X1nDon9/Rocket-onboard-computer-automatic-parachute-deployment-and-recovery-system/README.md

# Rocket-onboard-computer-automatic-parachute-deployment-and-recovery-system
来自哈尔滨工业大学的学生团队,设计结构并研发了火箭机载控制系统,完成了非常简单的功能,这是我们两周时间验证力学结构设计和嵌入式开发的重要探索
