X1nDon9/Rocket-onboard-computer-automatic-parachute-deployment-and-recovery-system/Satellite/satelite说明.md

这是一个基于stm32f103c8t6的小卫星,结构简单
主要的功能外设硬件有BMP280气压计,IMU9250,LORA_433MHz(ATK285-1)
还有一个简单的小MG90S舵机作为卫星弹簧开伞的限位模块
