X1nDon9/Rocket-onboard-computer-automatic-parachute-deployment-and-recovery-system/Rocket main/code/火箭机载电脑代码.md

这是基于stm32f103c8t6的一个主控板

它能实现的主要功能有
三个模式:
①准备模式下,可以通过两个自复位式开关测试开伞装置和卫星载荷抛出装置是否工作正常
②发射模式下,开启lora无线电遥测广播,以固定协议包双发冗余的方式;主要数据有火箭姿态,载荷抛出于开伞状态,高度,GPS数据,时间戳等数据
③数据回查模式,落地后,屏幕上会显示累计最大高度

主要功能外设有:
BMP280气压计,IMU9250姿态模块,LORA无线电模块,通讯频段(在410Mhz-433MHz可调)
