X1nDon9/Rocket-onboard-computer-automatic-parachute-deployment-and-recovery-system/Rocket main/code/火箭电子系统.docx

###### 火箭电子系统

运行要求:全自动闭环运行,不能远程控制释放载荷时机

形状:圆柱体模块,可拆卸,直径取决于箭体空间,高度尽量小

# 功能需求:

1 高度检测(分离点高度与实时高度(遥测传回))
2 摄像模块(需要箭体与卫星互拍证明)
3 视频存储模块(与摄像模块联动)
4 遥测通讯功能(数据需要保存记录以供赛后证明,我建议在地面站上做好时间戳对应)
5 下落速度(7-10m/s)
6 开伞回收机构

注意点:①模块化设计,支持快速重装(三分钟内)

7 释放高度证明(箭体与卫星两者分离时的高度)

# 硬件架构设想

主控:STM32F103C8T6

必要模块:①物理总开关(外露)与状态指示灯(上电GPIO控制即可)

8 LORA无线电模块(通讯方式UART串口或SPI)(需要物理独立开关和供电指示灯)
9 视频录制模块(必须独立,F103带不动视频帧解析,集成模块)
10 高度检测模块(I2C/SPI气压计(相比激光和超声波好上手),需要基准零点现场校准)
11 开伞机构(触发依据是什么呢,还没想好)
12 测试部分(为了方便我觉得可以几个开关分别控制火箭回收系统、弹出机构打开与无线电模块打开)
13 OLED屏幕

最大飞行高度 程序启动与发射就绪指示灯 遥测信号指示灯

遥测通道（十六进制） 卫星在位 / 脱离指示灯 卫星释放高度与时间

# 火箭电子系统重要模块传输说明

## 1、 GPS模块(正点原子ATK1218-BD)

通讯方式＆参数:USART3 38400波特率 8位 校验None 停止位1

硬件 | 引脚
STM32 | PB10(TXD) | PB11(RXD) | 无 | 3.3V | GND
GPS | RXD | TXD | PPS | VCC | GND
用途 | STM32发 GPS收 | GPS发 STM32收 | ns级时间脉冲 | 取电

GPS协议(NMEA-0183 V3.01标准)(输出语句组频率1Hz)

语句组示例

$GNGGA,081236.50,2232.25048,N,11356.20097,E,1,12,0.8,85.3,M,-2.6,M,,*5B

$GNGLL,2232.25048,N,11356.20097,E,081236.50,A,A*4C

$GNGSA,A,3,10,13,18,24,25,31,32,36,41,44,,,,1.2,0.8,0.9*31

$GNGSA,A,3,03,06,07,09,10,24,25,31,32,33,36,41,1.2,0.8,0.9*2F

$GPGSV,3,1,12,10,58,127,39,13,44,058,40,18,31,300,35,24,45,244,41*7D

$GPGSV,3,2,12,25,12,037,31,31,22,185,42,32,71,270,44,36,27,315,34*78

$GPGSV,3,3,12,41,28,100,38,44,38,045,40,,,,,,*43

$BDGSV,2,1,09,03,32,128,35,06,18,212,36,07,58,320,40,09,29,045,38*6F

$BDGSV,2,2,09,10,55,078,41,24,29,166,39,25,61,256,42,31,44,320,43*6D

$GNRMC,081236.50,A,2232.25048,N,11356.20097,E,0.298,201.88,251206,,,A*63

$GNZDA,081236.50,25,12,06,00,00*4B

语句 | 说明 | 主要字段(示例中)
GNGGA | 全球定位系统定位数据 | 时间: 08:12:36.50 纬度: 22°32.25048' N 经度: 113°56.20097' E 定位质量: 1 (GPS fix) 卫星数: 12 海拔高度: 85.3 m
GNGSA | 当前卫星信息（精度因子） | 模式: 3D定位 PDOP: 1.2 HDOP: 0.8 VDOP: 0.9
GPGSV / BDGSV | 可见卫星信息（GPS / 北斗） | 每颗卫星的仰角、方位角、信噪比等
GNRMC | 推荐最小定位信息 | 状态: A (有效定位) 速度: 0.298 节 航向: 201.88° 日期: 2025年12月06日
GNZDA | UTC 时间与日期 | 状态: A (有效定位) 速度: 0.298 节 航向: 201.88° 日期: 2025年12月06日

## 2、 GY-91(IMU＋Baro模块)

通讯方式:硬件SPI1

硬件 | 引脚
STM32 | PA4 | PA5 | PA6 | PA7 | 3.3V | GND
GY-91 | CS | SCK | SDO(MISO) | SDI(MOSI/0 | VCC | GND
用途 | 片选 (通断) | 时钟线 | 主机输入 从机输出 | 主机输出 从机输入 | 取电

## 3、 LORA模块

通讯方式:USART2+模式控制

硬件 | 引脚
STM32 | PA2(TXD) | PA3(RXD) | PB12 | PB13 | PB14 | 3.3V | GND
LORA模块 | RXD | TXD | AUX | M0 | M1 | VCC | GND
用途 | STM32发 LORA收 | LORA发 STM32收 | 状态引脚 | 模式组合 | | 取电

特别需要注意的点:

1 模式切换流程

检查AUX：读取 AUX 引脚电平，确保其为高电平

切换模式：设置 M1、M0 引脚到目标电平组合

等待稳定：等待至少10毫秒，让模块稳定地切换到新模式

2 发送数据检查：

在调用 HAL_UART_Transmit() 发送数据前，先检查 AUX 引脚。如果 AUX 为高电平（模块空闲），则可以安全发送；如果 AUX 为低电平（模块正忙），则应等待其变为高电平后再发送，以防数据丢失

3 天线安全（极高优先级）：上电前，务必确保天线已可靠连接！ 在未连接天线的情况下给模块上电，尤其是在发射状态，射频能量无法释放，可能会瞬间烧毁模块的功放芯片

LORA工作模式配置
模式 | M0 | M1 | 工作模式 | 用途说明
模式 0 | 0 (低电平) | 0 (低电平) | 透传模式 | 原样发送
模式 1 | 1 (高电平) | 0 (低电平) | WOR 模式 | 实现低功耗的“唤醒”
模式 2 | 0 (低电平) | 1 (高电平) | 配置模式 | 通过串口发送 AT 指令来读写模块内部寄存器，进行高级配置
模式 3 | 1 (高电平) | 1 (高电平) | 深度休眠模式 | 模块功耗极低，可用于省电。唤醒后模块会重新复位

## 4、 OLED屏幕模块

通讯方式:IIC1

硬件 | 引脚
STM32 | PB6 | PB7 | 3.3V | GND
OLED模块 | SCL | SDA | VCC | GND
用途 | 时钟线 | 半双工数据 | 取电
