X1nDon9/Rocket-onboard-computer-automatic-parachute-deployment-and-recovery-system/Rocket main/code/新LORA.png

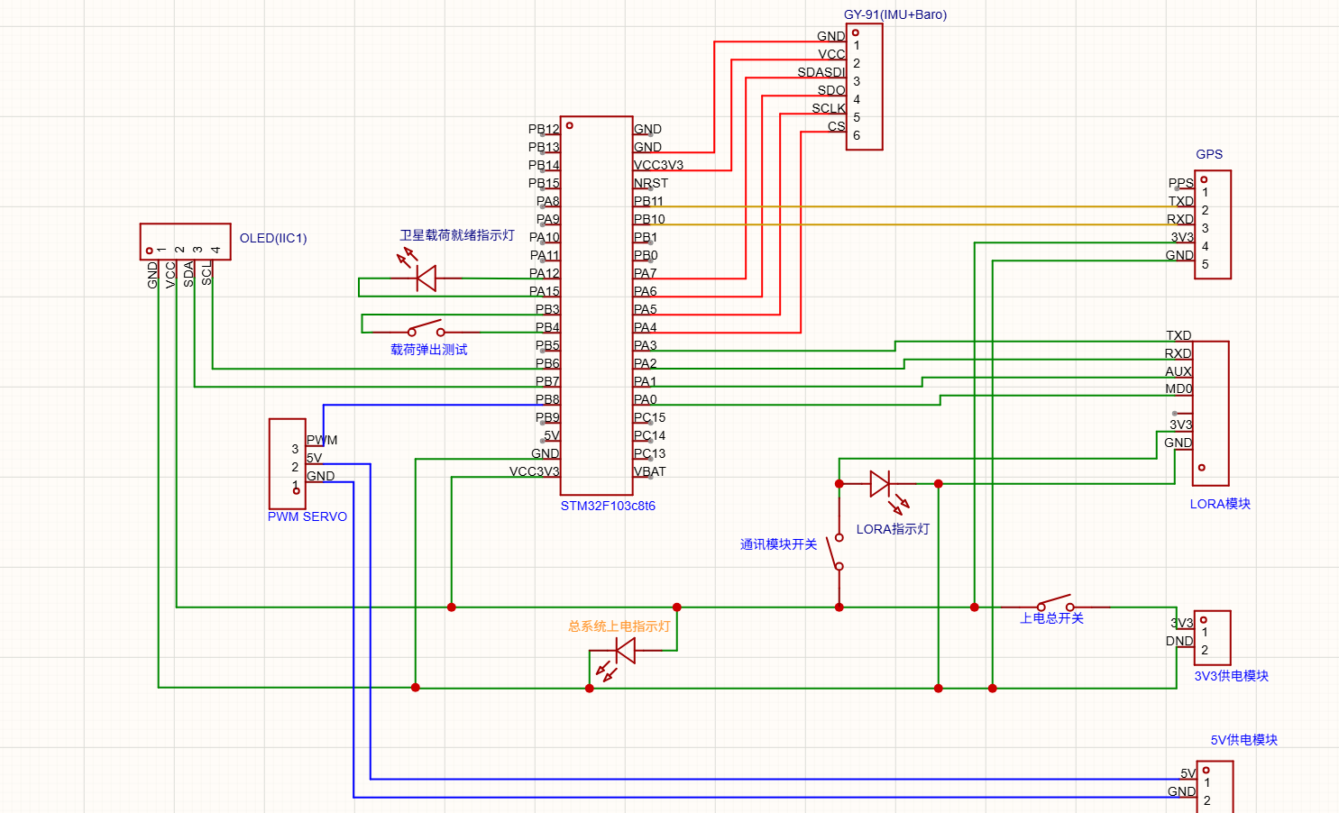
Rocket main/code/新LORA.png
