X1nDon9/Rocket-onboard-computer-automatic-parachute-deployment-and-recovery-system/Rocket main/火箭建模/火箭主体(无药仓无舵机打印件).SLDASM

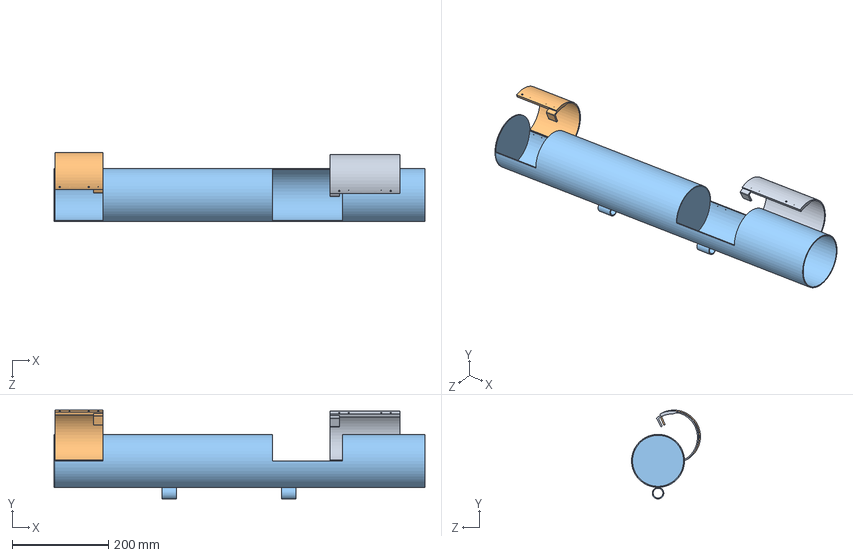
[picture p2: CAD file, 2026-09-14]
Rocket main/火箭建模/火箭主体(无药仓无舵机打印件).SLDASM
770.0 x 184.3 x 143.1 mm
火箭体
伞仓门
卫星仓门
