X1nDon9/Rocket-onboard-computer-automatic-parachute-deployment-and-recovery-system/Rocket main/火箭建模/火箭主体.SLDASM

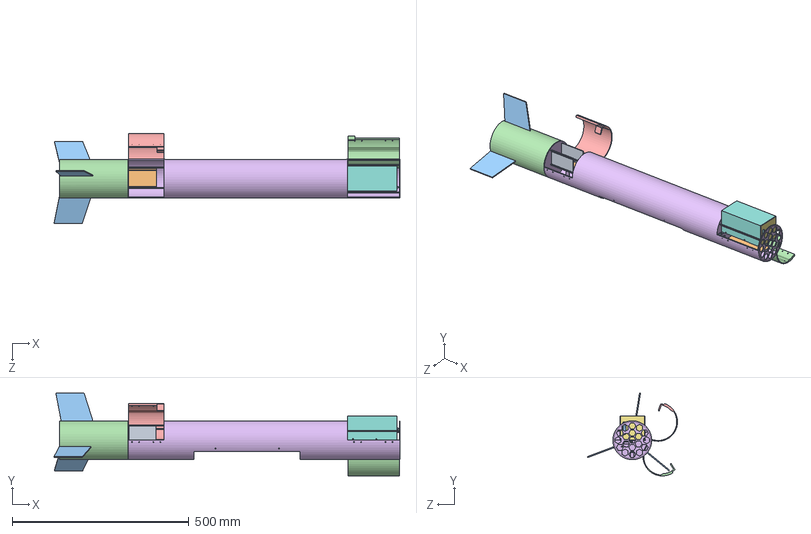
[picture p3: CAD file, 2026-09-14]
Rocket main/火箭建模/火箭主体.SLDASM
978.9 x 234.5 x 254.7 mm
火箭体（调高重心）
伞仓门
卫星仓门
舵机 x 3
卫星仓推板
卫星侧开盖
卫星结构
卫星伞盖
卫星伞舱推板
碳杆 x 4
药仓滑槽
尾翼 x 3
伞舱推板改后
伞舱推板立板 x 2
