X1nDon9/Rocket-onboard-computer-automatic-parachute-deployment-and-recovery-system/Rocket main/火箭建模/卫星装配.SLDASM

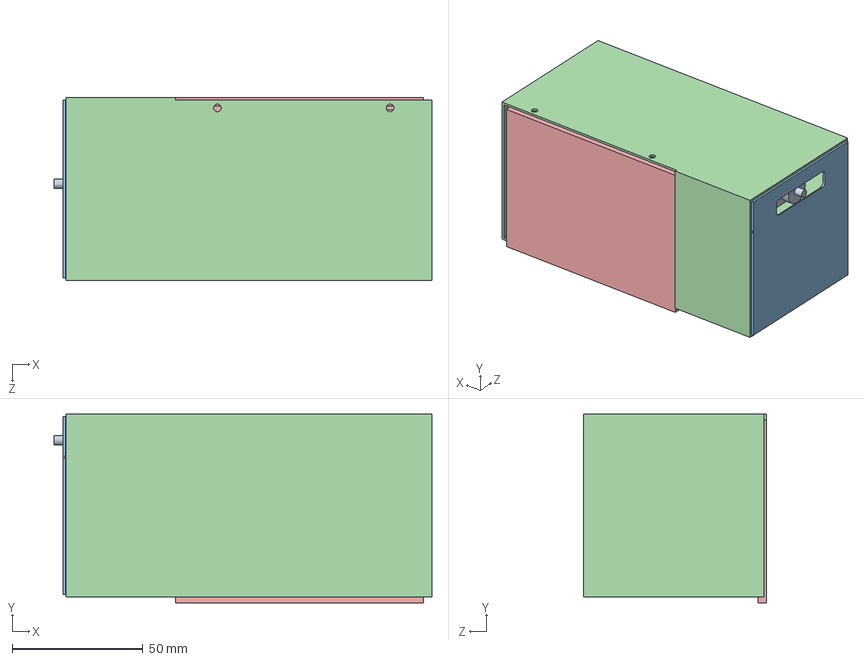
[picture p4: CAD file, 2026-09-14]
Rocket main/火箭建模/卫星装配.SLDASM
144.5 x 72.2 x 70.0 mm
卫星侧开盖
卫星结构
卫星伞盖
卫星伞舱推板
舵机
