X1nDon9/Rocket-onboard-computer-automatic-parachute-deployment-and-recovery-system/Rocket main/火箭建模/卫星伞舱推板.SLDPRT

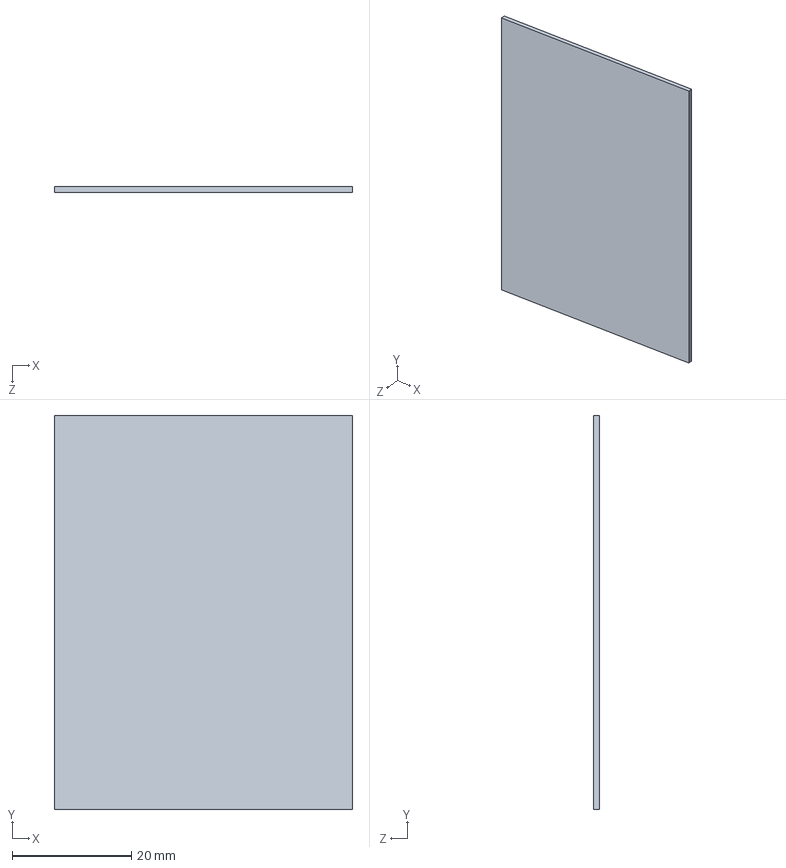
[picture p5: CAD file, 2026-09-14]
Rocket main/火箭建模/卫星伞舱推板.SLDPRT
50.0 x 66.0 x 1.00 mm
