X1nDon9/Rocket-onboard-computer-automatic-parachute-deployment-and-recovery-system/Rocket main/火箭建模/药仓.SLDPRT

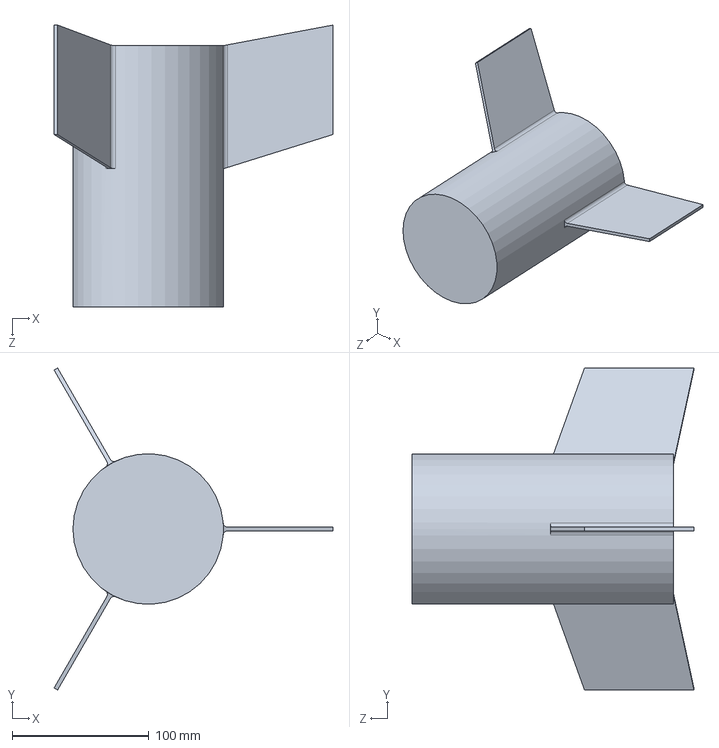
[picture p6: CAD file, 2026-09-14]
Rocket main/火箭建模/药仓.SLDPRT
203.8 x 235.3 x 206.0 mm
