X1nDon9/Rocket-onboard-computer-automatic-parachute-deployment-and-recovery-system/Rocket main/火箭建模/火箭主体 - 头锥-1.STL

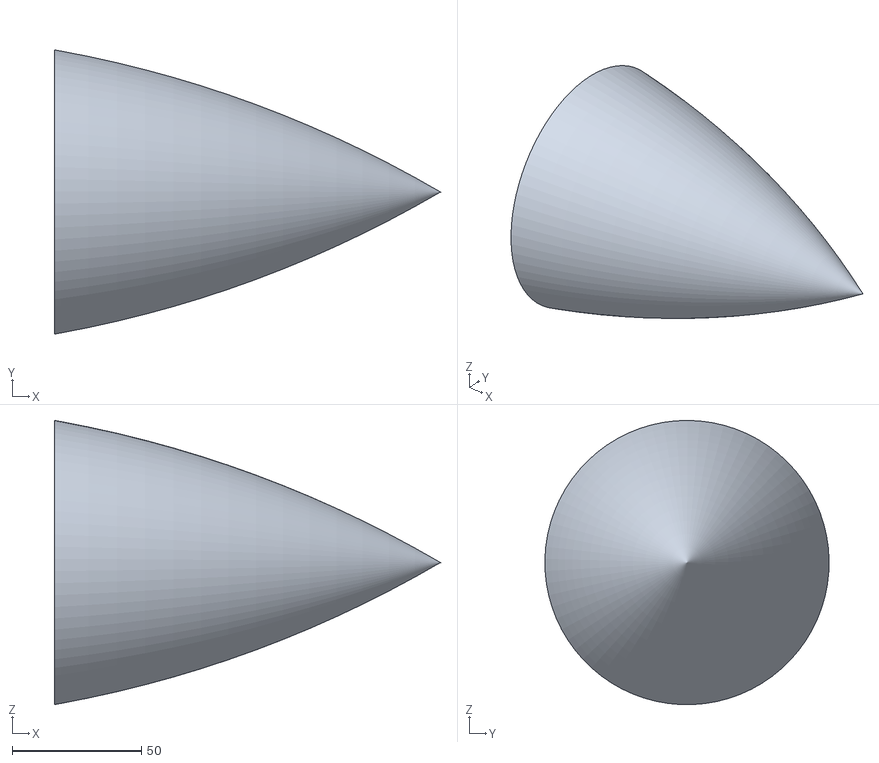
[picture p8: CAD file, 2026-09-14]
Rocket main/火箭建模/火箭主体 - 头锥-1.STL
149.4 x 110.0 x 110.0
