X1nDon9/Rocket-onboard-computer-automatic-parachute-deployment-and-recovery-system/Rocket main/火箭建模/火箭体.SLDPRT

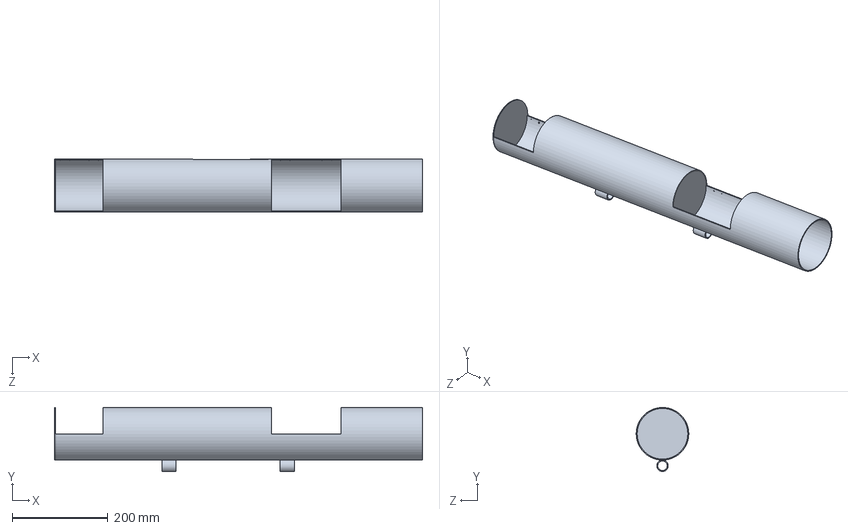
[picture p9: CAD file, 2026-09-14]
Rocket main/火箭建模/火箭体.SLDPRT
770.0 x 134.0 x 110.0 mm
