X1nDon9/Rocket-onboard-computer-automatic-parachute-deployment-and-recovery-system/Rocket main/火箭建模/伞仓门.SLDPRT

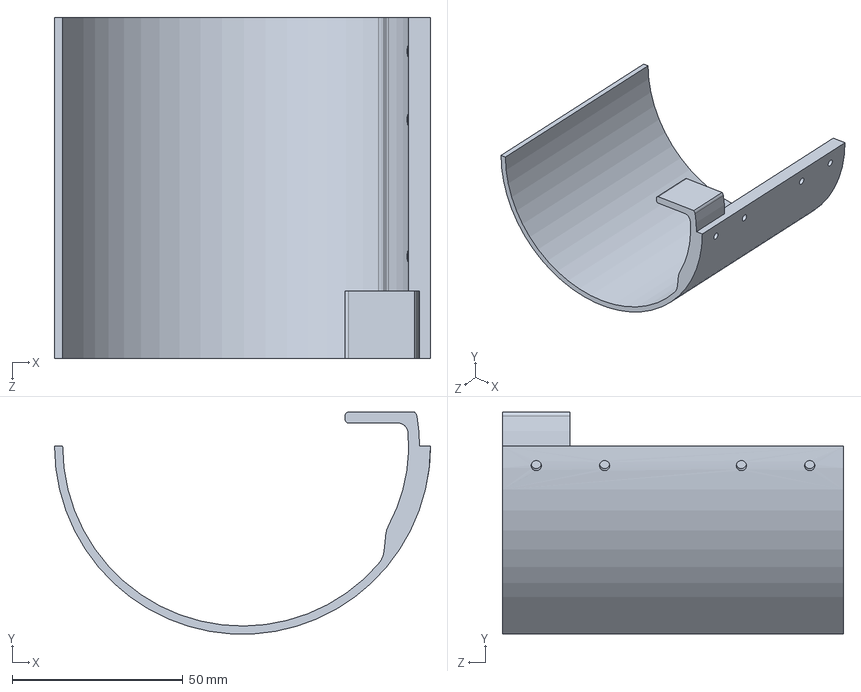
[picture p10: CAD file, 2026-09-14]
Rocket main/火箭建模/伞仓门.SLDPRT
110.0 x 64.9 x 99.8 mm
