X1nDon9/Rocket-onboard-computer-automatic-parachute-deployment-and-recovery-system/Rocket main/火箭建模/火箭体（调高重心）.SLDPRT

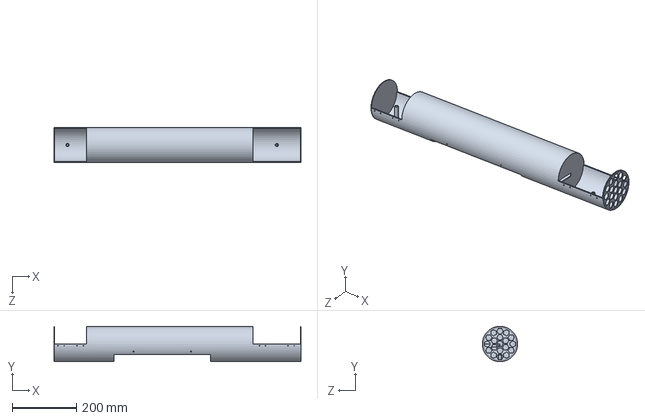
[picture p11: CAD file, 2026-09-14]
Rocket main/火箭建模/火箭体（调高重心）.SLDPRT
770.0 x 110.0 x 110.0 mm
