X1nDon9/Rocket-onboard-computer-automatic-parachute-deployment-and-recovery-system/Rocket main/火箭建模/电控仓门.SLDPRT

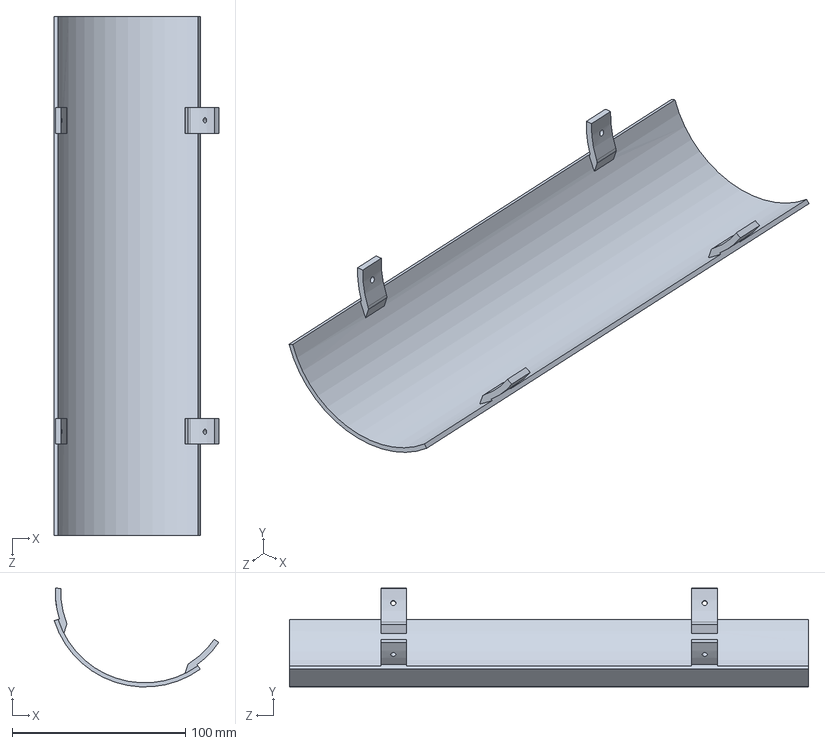
[picture p12: CAD file, 2026-09-14]
Rocket main/火箭建模/电控仓门.SLDPRT
95.2 x 57.1 x 300.0 mm
