X1nDon9/Rocket-onboard-computer-automatic-parachute-deployment-and-recovery-system/Rocket main/火箭建模/伞舱推板立板.SLDPRT

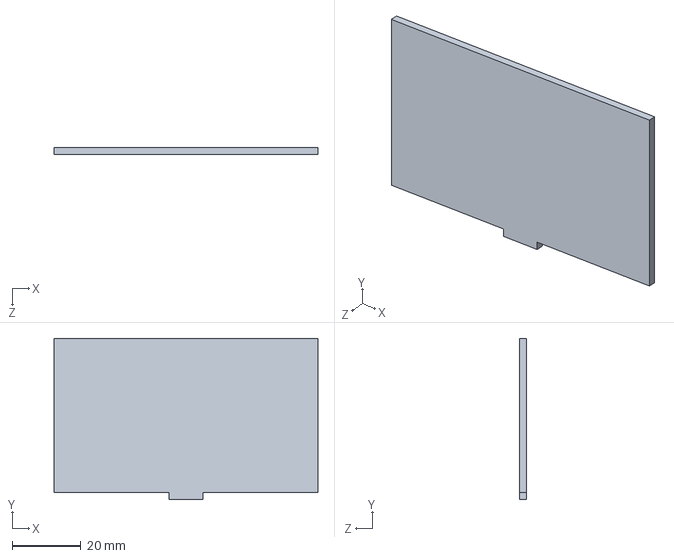
[picture p13: CAD file, 2026-09-14]
Rocket main/火箭建模/伞舱推板立板.SLDPRT
77.0 x 47.0 x 2.00 mm
