X1nDon9/Rocket-onboard-computer-automatic-parachute-deployment-and-recovery-system/Rocket main/火箭建模/伞舱推板.SLDPRT

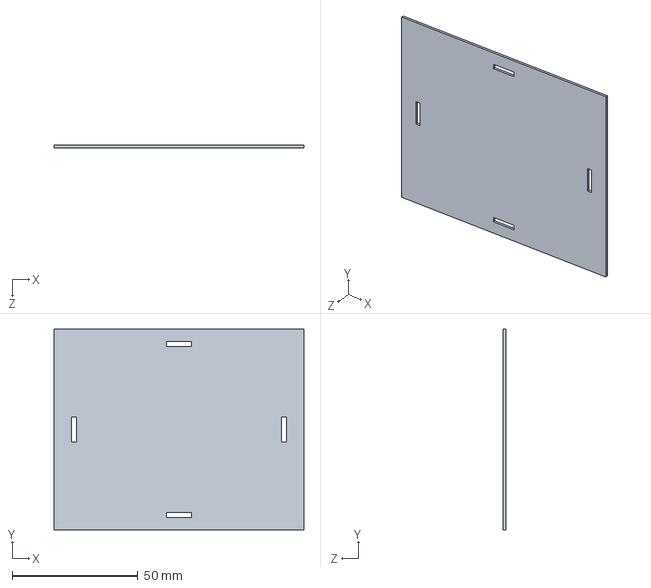
[picture p14: CAD file, 2026-09-14]
Rocket main/火箭建模/伞舱推板.SLDPRT
99.6 x 80.0 x 1.00 mm
