X1nDon9/Rocket-onboard-computer-automatic-parachute-deployment-and-recovery-system/Rocket main/火箭建模/卫星结构.SLDPRT

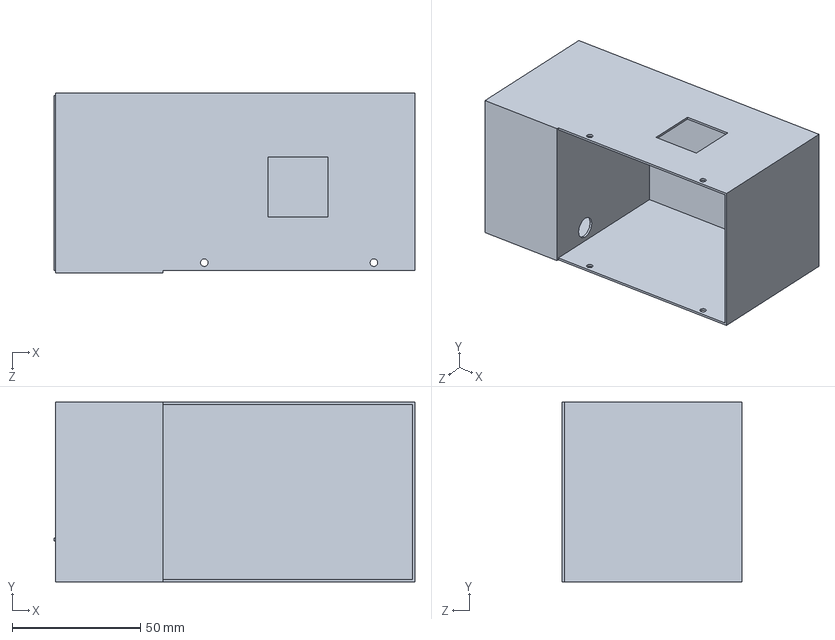
[picture p15: CAD file, 2026-09-14]
Rocket main/火箭建模/卫星结构.SLDPRT
140.5 x 70.0 x 70.0 mm
