X1nDon9/Rocket-onboard-computer-automatic-parachute-deployment-and-recovery-system/Rocket main/火箭建模/卫星伞盖.SLDPRT

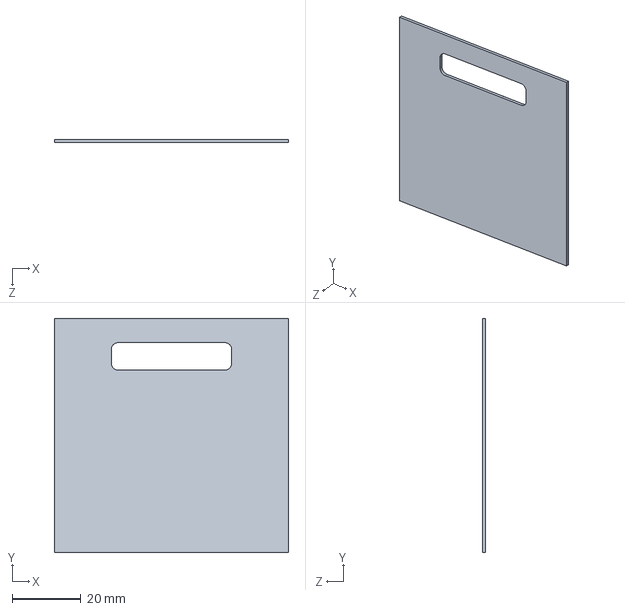
[picture p16: CAD file, 2026-09-14]
Rocket main/火箭建模/卫星伞盖.SLDPRT
68.0 x 68.0 x 1.00 mm
