X1nDon9/Rocket-onboard-computer-automatic-parachute-deployment-and-recovery-system/Rocket main/火箭建模/药仓滑槽.SLDPRT

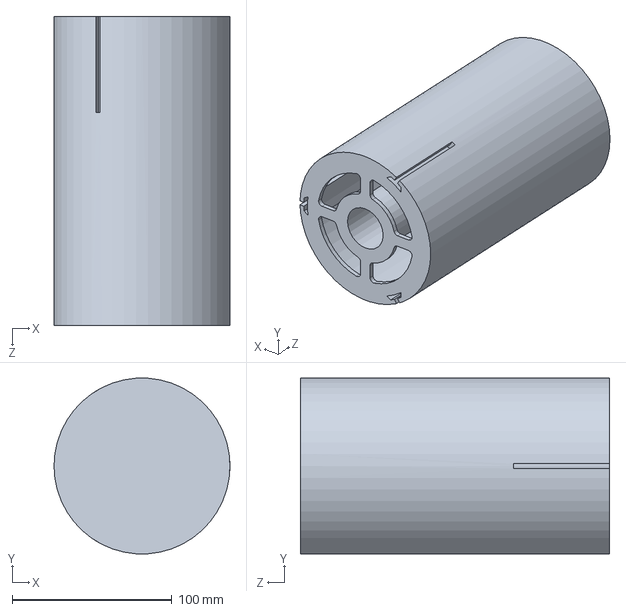
[picture p17: CAD file, 2026-09-14]
Rocket main/火箭建模/药仓滑槽.SLDPRT
110.0 x 110.0 x 193.2 mm
