X1nDon9/Rocket-onboard-computer-automatic-parachute-deployment-and-recovery-system/Rocket main/火箭建模/舵机.SLDPRT

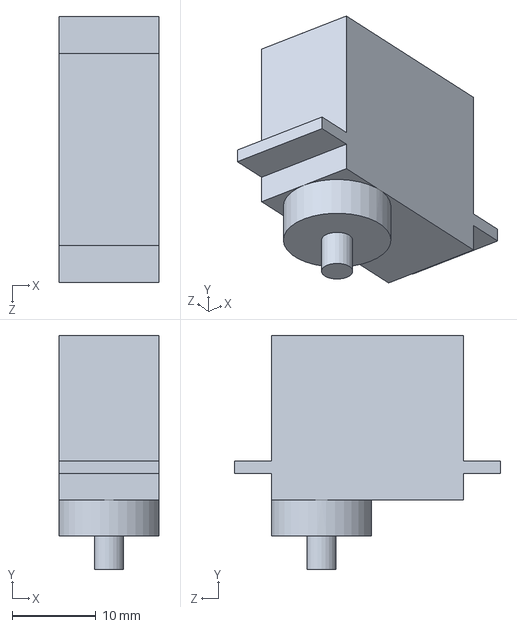
[picture p18: CAD file, 2026-09-14]
Rocket main/火箭建模/舵机.SLDPRT
12.0 x 28.0 x 31.8 mm
