X1nDon9/Rocket-onboard-computer-automatic-parachute-deployment-and-recovery-system/Rocket main/火箭建模/尾翼.SLDPRT

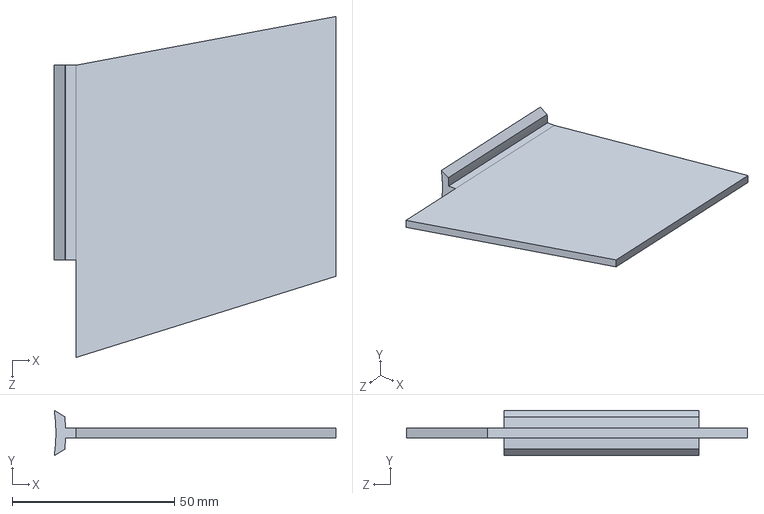
[picture p19: CAD file, 2026-09-14]
Rocket main/火箭建模/尾翼.SLDPRT
86.7 x 14.0 x 105.0 mm
