X1nDon9/Rocket-onboard-computer-automatic-parachute-deployment-and-recovery-system/Rocket main/火箭建模/卫星仓推板.SLDPRT

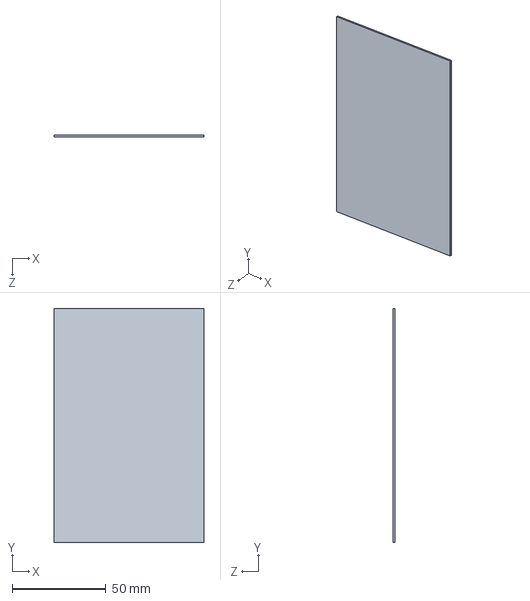
[picture p20: CAD file, 2026-09-14]
Rocket main/火箭建模/卫星仓推板.SLDPRT
80.0 x 125.0 x 1.00 mm
