X1nDon9/Rocket-onboard-computer-automatic-parachute-deployment-and-recovery-system/Rocket main/火箭建模/卫星侧开盖.SLDPRT

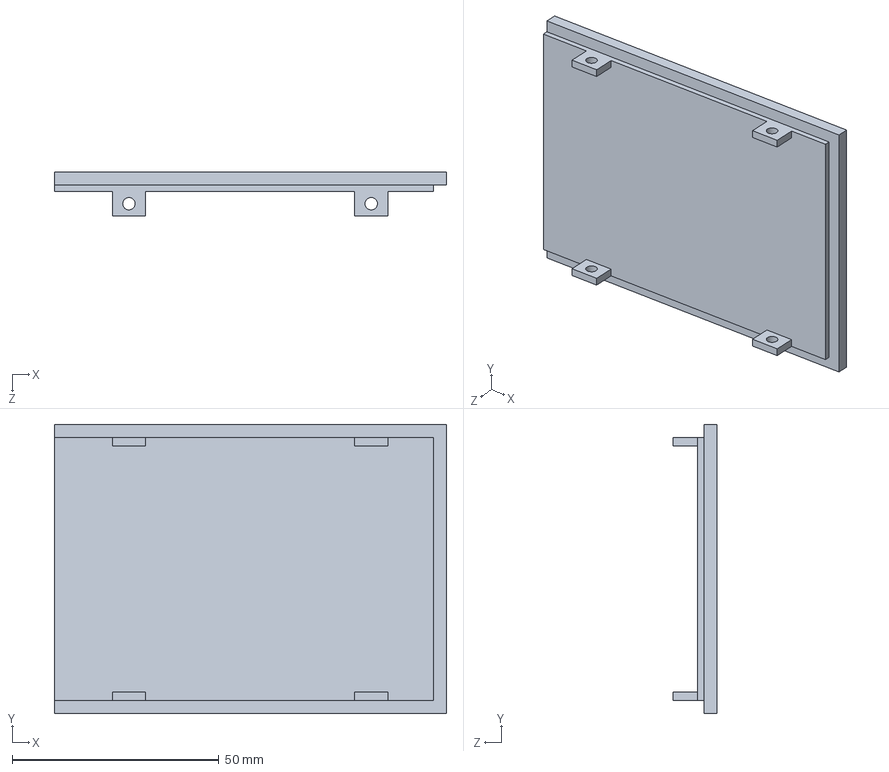
[picture p21: CAD file, 2026-09-14]
Rocket main/火箭建模/卫星侧开盖.SLDPRT
94.8 x 70.0 x 10.7 mm
