X1nDon9/Rocket-onboard-computer-automatic-parachute-deployment-and-recovery-system/Rocket main/火箭建模/卫星门.SLDPRT

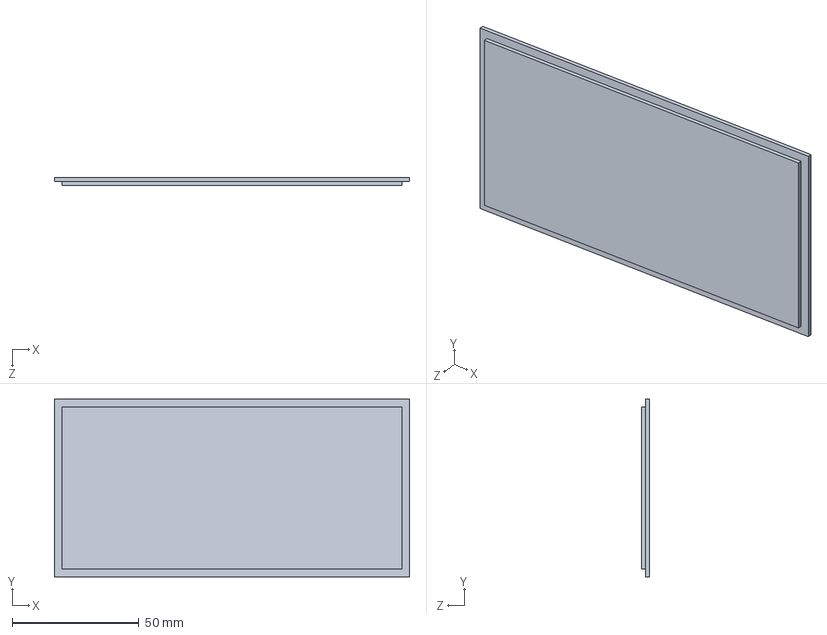
[picture p22: CAD file, 2026-09-14]
Rocket main/火箭建模/卫星门.SLDPRT
140.0 x 70.0 x 3.00 mm
