X1nDon9/Rocket-onboard-computer-automatic-parachute-deployment-and-recovery-system/Rocket main/火箭建模/伞舱推板改后.SLDPRT

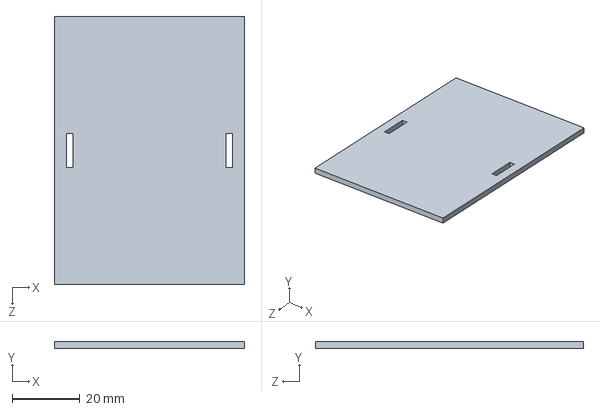
[picture p23: CAD file, 2026-09-14]
Rocket main/火箭建模/伞舱推板改后.SLDPRT
56.0 x 2.00 x 79.0 mm
