X1nDon9/Rocket-onboard-computer-automatic-parachute-deployment-and-recovery-system/Rocket main/火箭建模/碳杆.SLDPRT

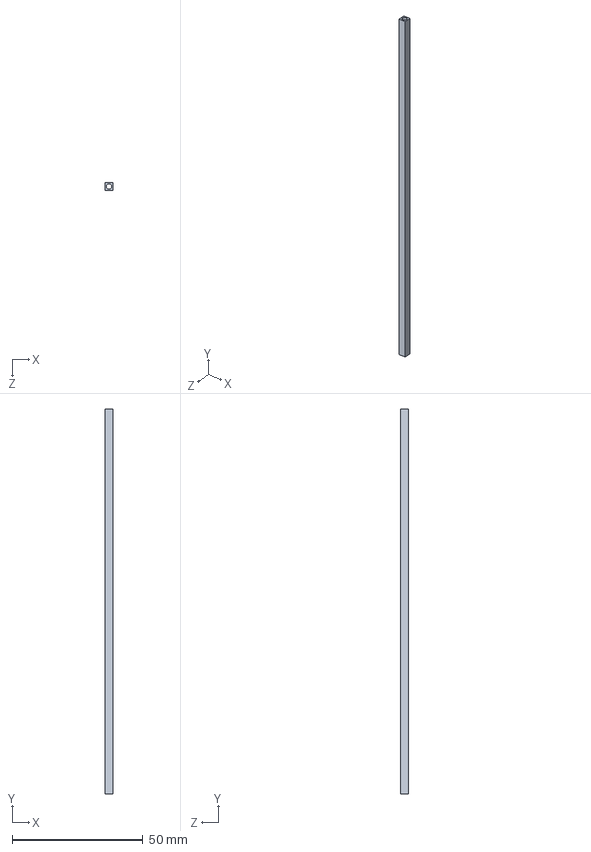
[picture p24: CAD file, 2026-09-14]
Rocket main/火箭建模/碳杆.SLDPRT
3.00 x 147.0 x 3.00 mm
