X1nDon9/Rocket-onboard-computer-automatic-parachute-deployment-and-recovery-system/Rocket main/火箭建模/伞舱推板立板1.SLDPRT

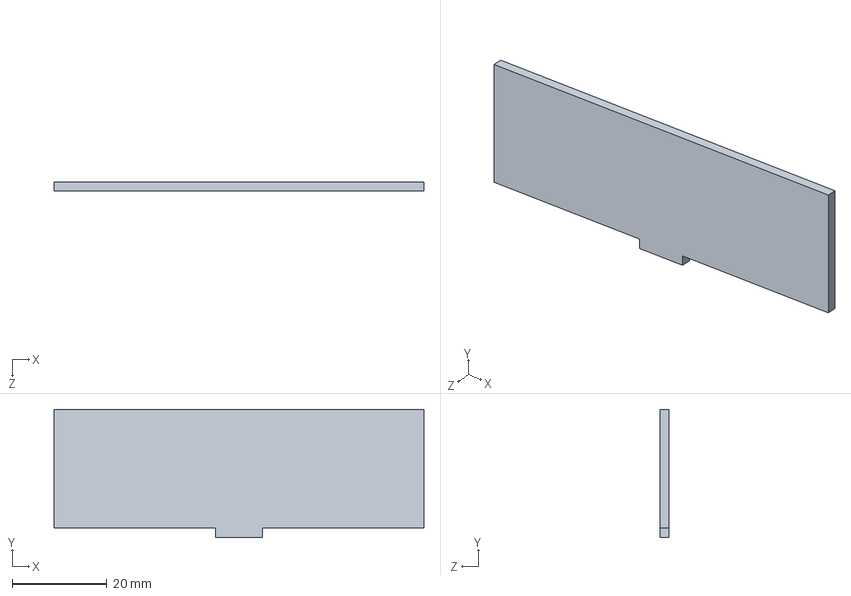
[picture p25: CAD file, 2026-09-14]
Rocket main/火箭建模/伞舱推板立板1.SLDPRT
78.0 x 27.0 x 2.00 mm
