X1nDon9/Rocket-onboard-computer-automatic-parachute-deployment-and-recovery-system/(list of files, cad)

Other CAD files:
Rocket main/火箭建模/头锥 - 副本.SLDPRT
Rocket main/火箭建模/伞仓门 - 副本.SLDPRT
Rocket main/火箭建模/伞舱推板 - 副本.SLDPRT
Rocket main/火箭建模/卫星仓门 - 副本.SLDPRT
Rocket main/火箭建模/火箭主体 - 副本.SLDASM
Rocket main/火箭建模/火箭体 - 副本.SLDPRT
Rocket main/火箭建模/电控仓门 - 副本.SLDPRT
Rocket main/火箭建模/舵机 - 副本.SLDPRT
